drelectro/ns32k-timewarp/Memory.kicad_sch

## KiCad design Memory.kicad_sch (2025-10-30)

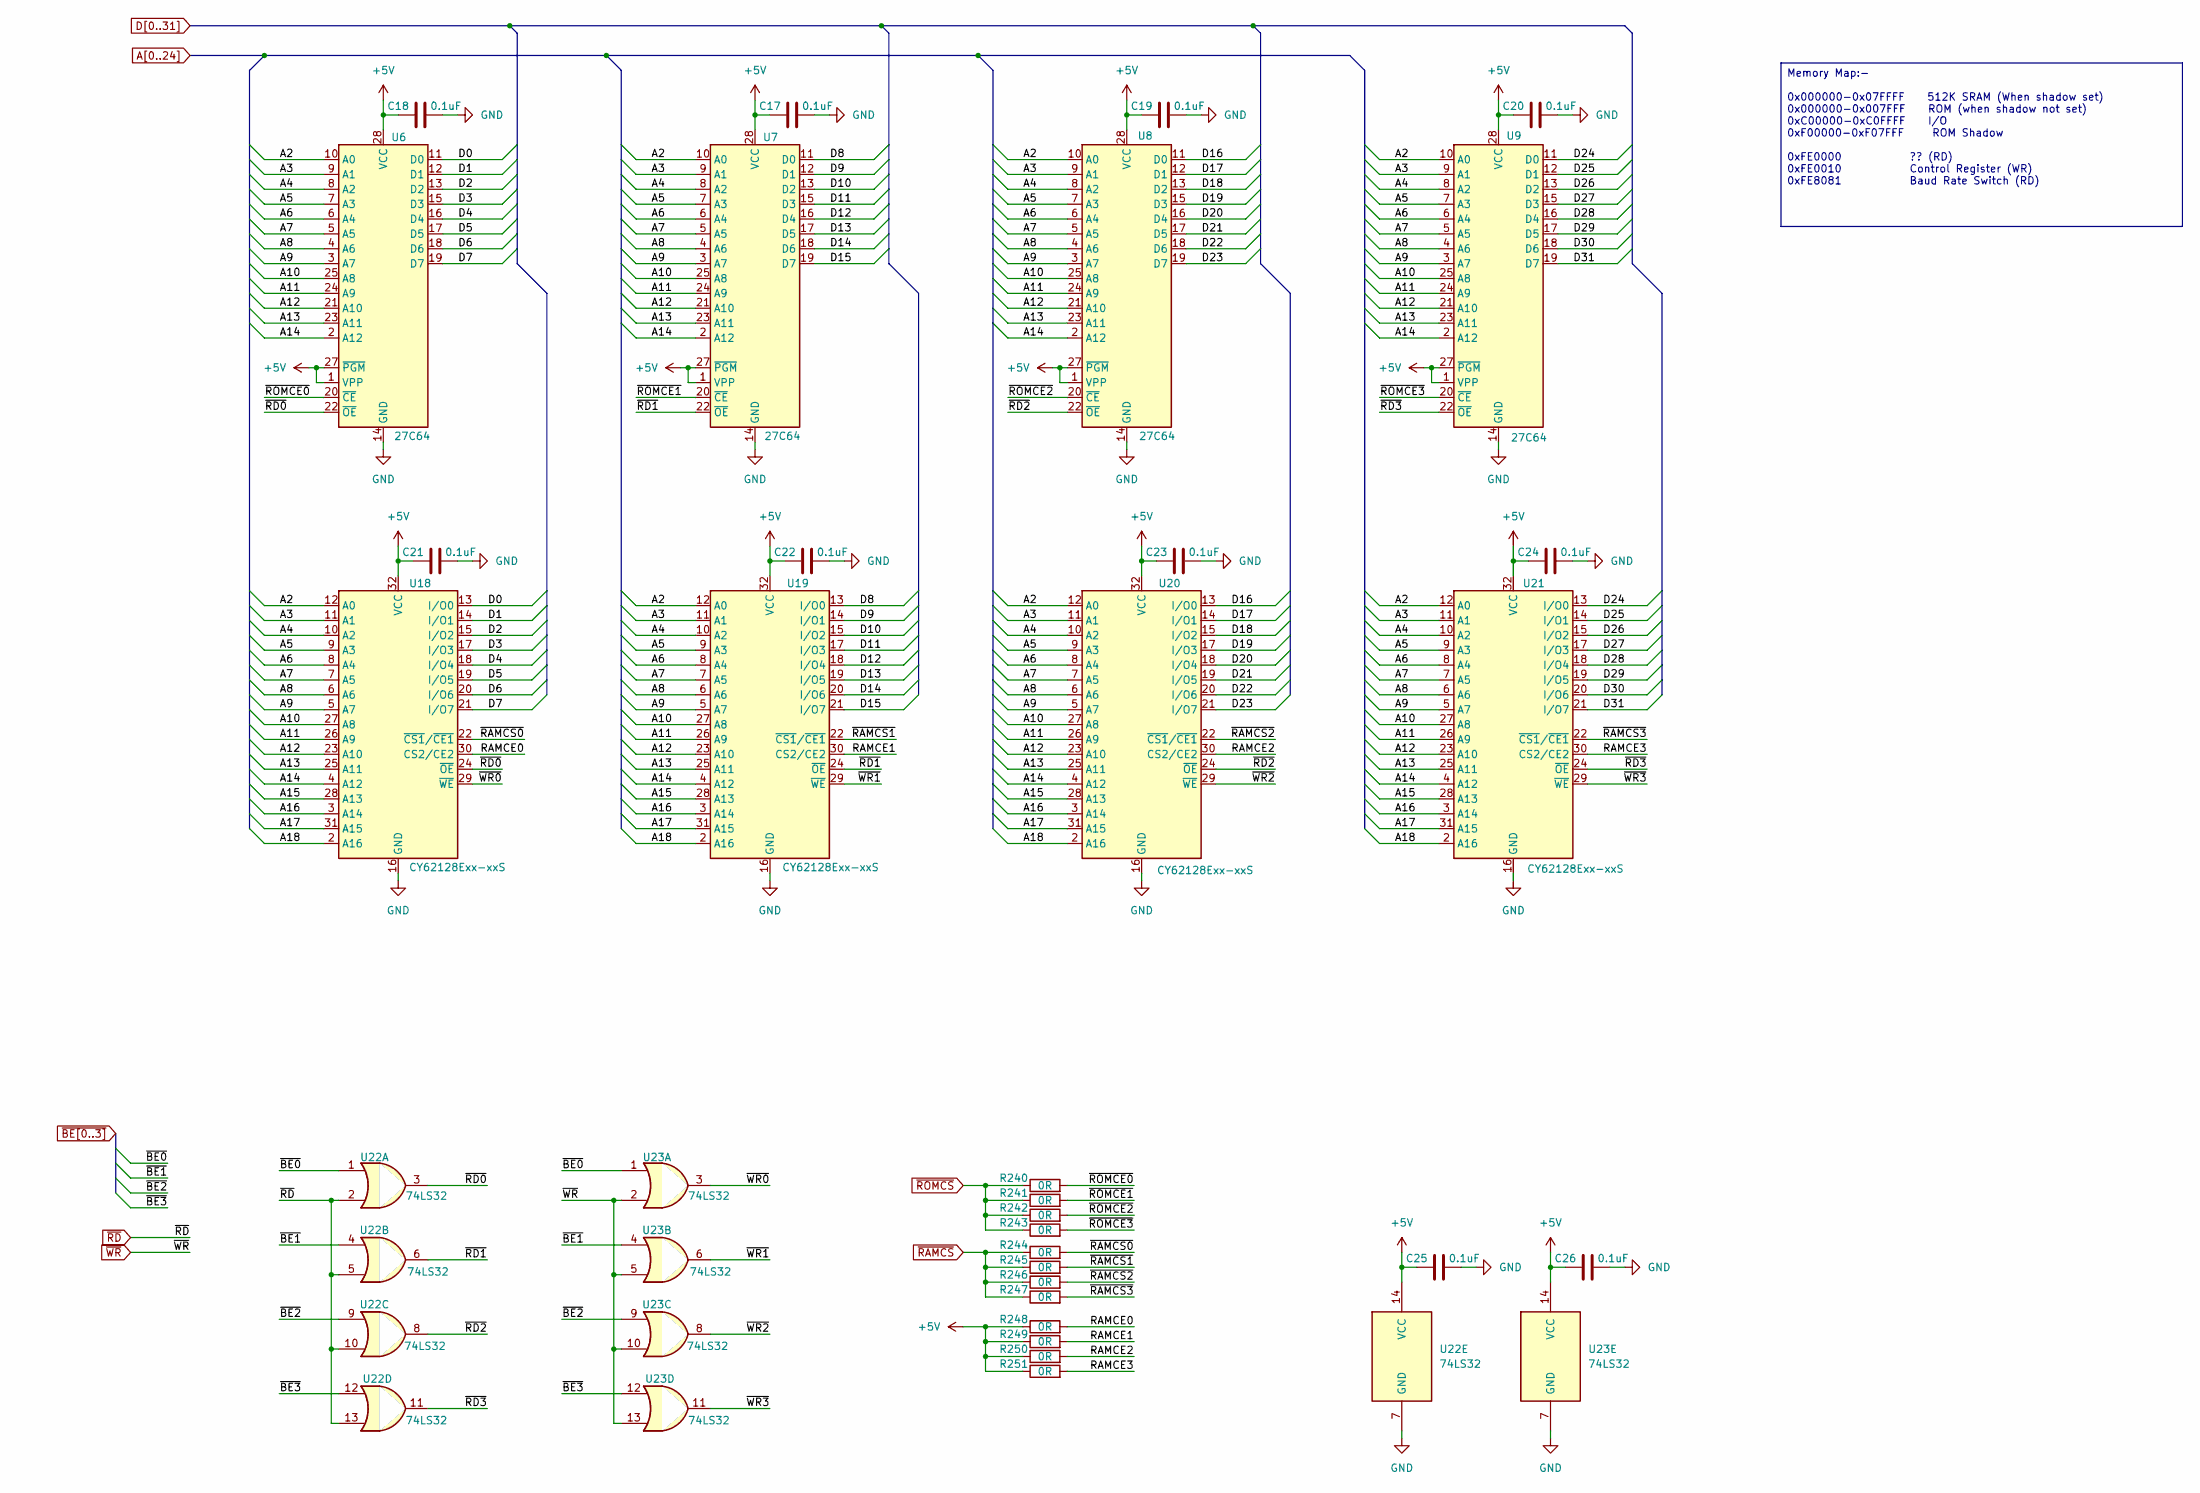
[picture p1: schematic Memory.kicad_sch]

Parts:
C17, C18, C19, C20, C21, C22, C23, C24, C25, C26: 0.1uF; C_0603_1608Metric_Pad1.08x0.95mm_HandSolder
R240, R241, R242, R243, R244, R245, R246, R247, R248, R249, R250, R251: 0R; R_0603_1608Metric_Pad0.98x0.95mm_HandSolder
U6, U7, U8, U9: 27C64; DIP-28_W15.24mm
U18, U19, U20, U21: CY62128Exx-xxS; SOP-32_11.305x20.495mm_P1.27mm
U22, U23: 74LS32; DIP-14_W7.62mm_Socket_LongPads

Connections:
+5V: C17.1, C18.1, C19.1, C20.1, C21.1, C22.1, C23.1, C24.1, C25.1, C26.1, R248.1, R249.1, R250.1, R251.1, U6.1 (VPP), U6.27 (~PGM), U6.28 (VCC), U7.1 (VPP), U7.27 (~PGM), U7.28 (VCC), U8.1 (VPP), U8.27 (~PGM), U8.28 (VCC), U9.1 (VPP), U9.27 (~PGM), U9.28 (VCC), U18.32 (VCC), U19.32 (VCC), U20.32 (VCC), U21.32 (VCC), U22.14 (VCC), U23.14 (VCC)
A2: U6.10 (A0), U7.10 (A0), U8.10 (A0), U9.10 (A0), U18.12 (A0), U19.12 (A0), U20.12 (A0), U21.12 (A0)
A3: U6.9 (A1), U7.9 (A1), U8.9 (A1), U9.9 (A1), U18.11 (A1), U19.11 (A1), U20.11 (A1), U21.11 (A1)
A4: U6.8 (A2), U7.8 (A2), U8.8 (A2), U9.8 (A2), U18.10 (A2), U19.10 (A2), U20.10 (A2), U21.10 (A2)
A5: U6.7 (A3), U7.7 (A3), U8.7 (A3), U9.7 (A3), U18.9 (A3), U19.9 (A3), U20.9 (A3), U21.9 (A3)
A6: U6.6 (A4), U7.6 (A4), U8.6 (A4), U9.6 (A4), U18.8 (A4), U19.8 (A4), U20.8 (A4), U21.8 (A4)
A7: U6.5 (A5), U7.5 (A5), U8.5 (A5), U9.5 (A5), U18.7 (A5), U19.7 (A5), U20.7 (A5), U21.7 (A5)
A8: U6.4 (A6), U7.4 (A6), U8.4 (A6), U9.4 (A6), U18.6 (A6), U19.6 (A6), U20.6 (A6), U21.6 (A6)
A9: U6.3 (A7), U7.3 (A7), U8.3 (A7), U9.3 (A7), U18.5 (A7), U19.5 (A7), U20.5 (A7), U21.5 (A7)
A10: U6.25 (A8), U7.25 (A8), U8.25 (A8), U9.25 (A8), U18.27 (A8), U19.27 (A8), U20.27 (A8), U21.27 (A8)
A11: U6.24 (A9), U7.24 (A9), U8.24 (A9), U9.24 (A9), U18.26 (A9), U19.26 (A9), U20.26 (A9), U21.26 (A9)
A12: U6.21 (A10), U7.21 (A10), U8.21 (A10), U9.21 (A10), U18.23 (A10), U19.23 (A10), U20.23 (A10), U21.23 (A10)
A13: U6.23 (A11), U7.23 (A11), U8.23 (A11), U9.23 (A11), U18.25 (A11), U19.25 (A11), U20.25 (A11), U21.25 (A11)
A14: U6.2 (A12), U7.2 (A12), U8.2 (A12), U9.2 (A12), U18.4 (A12), U19.4 (A12), U20.4 (A12), U21.4 (A12)
A15: U18.28 (A13), U19.28 (A13), U20.28 (A13), U21.28 (A13)
A16: U18.3 (A14), U19.3 (A14), U20.3 (A14), U21.3 (A14)
A17: U18.31 (A15), U19.31 (A15), U20.31 (A15), U21.31 (A15)
A18: U18.2 (A16), U19.2 (A16), U20.2 (A16), U21.2 (A16)
D0: U6.11 (D0), U18.13 (I/O0)
D1: U6.12 (D1), U18.14 (I/O1)
D2: U6.13 (D2), U18.15 (I/O2)
D3: U6.15 (D3), U18.17 (I/O3)
D4: U6.16 (D4), U18.18 (I/O4)
D5: U6.17 (D5), U18.19 (I/O5)
D6: U6.18 (D6), U18.20 (I/O6)
D7: U6.19 (D7), U18.21 (I/O7)
D8: U7.11 (D0), U19.13 (I/O0)
D9: U7.12 (D1), U19.14 (I/O1)
D10: U7.13 (D2), U19.15 (I/O2)
D11: U7.15 (D3), U19.17 (I/O3)
D12: U7.16 (D4), U19.18 (I/O4)
D13: U7.17 (D5), U19.19 (I/O5)
D14: U7.18 (D6), U19.20 (I/O6)
D15: U7.19 (D7), U19.21 (I/O7)
D16: U8.11 (D0), U20.13 (I/O0)
D17: U8.12 (D1), U20.14 (I/O1)
D18: U8.13 (D2), U20.15 (I/O2)
D19: U8.15 (D3), U20.17 (I/O3)
D20: U8.16 (D4), U20.18 (I/O4)
D21: U8.17 (D5), U20.19 (I/O5)
D22: U8.18 (D6), U20.20 (I/O6)
D23: U8.19 (D7), U20.21 (I/O7)
D24: U9.11 (D0), U21.13 (I/O0)
D25: U9.12 (D1), U21.14 (I/O1)
D26: U9.13 (D2), U21.15 (I/O2)
D27: U9.15 (D3), U21.17 (I/O3)
D28: U9.16 (D4), U21.18 (I/O4)
D29: U9.17 (D5), U21.19 (I/O5)
D30: U9.18 (D6), U21.20 (I/O6)
D31: U9.19 (D7), U21.21 (I/O7)
GND: C17.2, C18.2, C19.2, C20.2, C21.2, C22.2, C23.2, C24.2, C25.2, C26.2, U6.14 (GND), U7.14 (GND), U8.14 (GND), U9.14 (GND), U18.16 (GND), U19.16 (GND), U20.16 (GND), U21.16 (GND), U22.7 (GND), U23.7 (GND)
RAMCE0: R248.2, U18.30 (CS2/CE2)
RAMCE1: R249.2, U19.30 (CS2/CE2)
RAMCE2: R250.2, U20.30 (CS2/CE2)
RAMCE3: R251.2, U21.30 (CS2/CE2)
~BE0: U22.1, U23.1
~BE1: U22.4, U23.4
~BE2: U22.9, U23.9
~BE3: U22.12, U23.12
~RAMCS0: R244.2, U18.22 (~CS1/~CE1)
~RAMCS1: R245.2, U19.22 (~CS1/~CE1)
~RAMCS2: R246.2, U20.22 (~CS1/~CE1)
~RAMCS3: R247.2, U21.22 (~CS1/~CE1)
~RAMCS: R244.1, R245.1, R246.1, R247.1
~RD0: U6.22 (~OE), U18.24 (~OE), U22.3
~RD1: U7.22 (~OE), U19.24 (~OE), U22.6
~RD2: U8.22 (~OE), U20.24 (~OE), U22.8
~RD3: U9.22 (~OE), U21.24 (~OE), U22.11
~RD: U22.2, U22.5, U22.10, U22.13
~ROMCE0: R240.2, U6.20 (~CE)
~ROMCE1: R241.2, U7.20 (~CE)
~ROMCE2: R242.2, U8.20 (~CE)
~ROMCE3: R243.2, U9.20 (~CE)
~ROMCS: R240.1, R241.1, R242.1, R243.1
~WR0: U18.29 (~WE), U23.3
~WR1: U19.29 (~WE), U23.6
~WR2: U20.29 (~WE), U23.8
~WR3: U21.29 (~WE), U23.11
~WR: U23.2, U23.5, U23.10, U23.13

Notes on the sheet:
Memory Map:- 0x000000-0x07FFFF 512K SRAM (When shadow set) 0x000000-0x007FFF ROM (when shadow not set) 0xC00000-0xC0FFFF I/O 0xF00000-0xF07FFF ROM Shadow 0xFE0000 ?? (RD) 0xFE0010 Control Register (WR) 0xFE8081 Baud Rate Switch (RD)
