drelectro/ns32k-timewarp/Peripherals.kicad_sch

## KiCad design Peripherals.kicad_sch (2025-10-30)

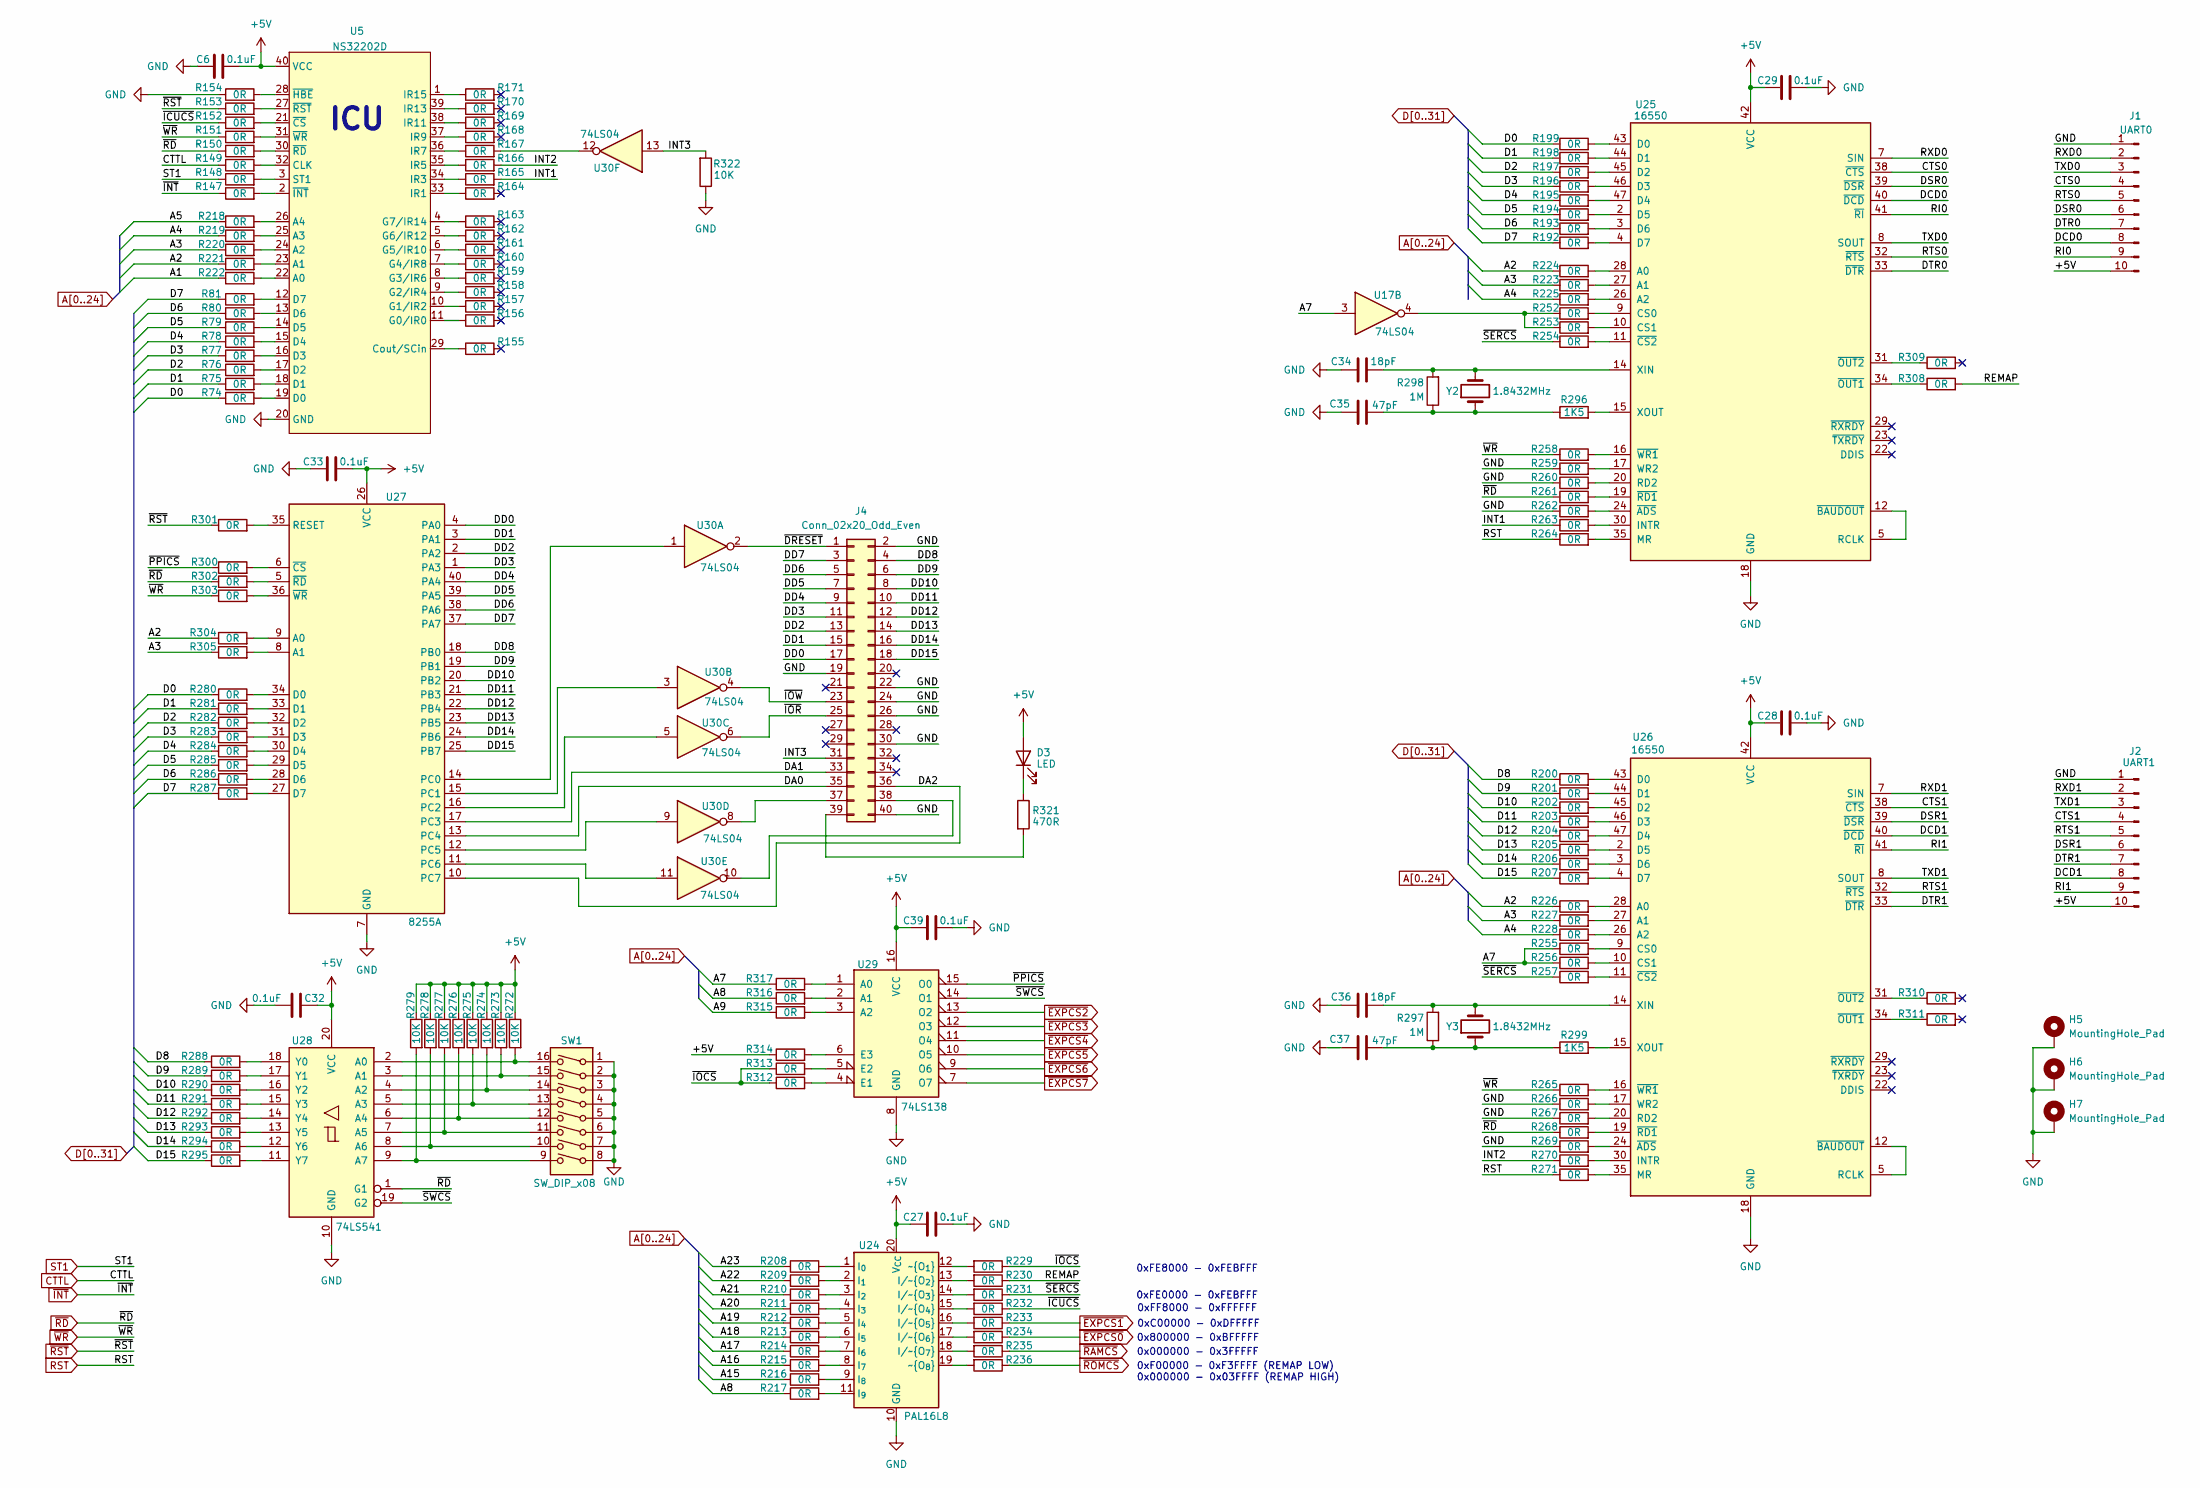
[picture p2: schematic Peripherals.kicad_sch]

Parts:
C6, C27, C28, C29, C32, C33, C39: 0.1uF; C_0603_1608Metric_Pad1.08x0.95mm_HandSolder
C34, C36: 18pF; C_0603_1608Metric_Pad1.08x0.95mm_HandSolder
C35, C37: 47pF; C_0603_1608Metric_Pad1.08x0.95mm_HandSolder
D3: LED; LED_0805_2012Metric_Pad1.15x1.40mm_HandSolder
H5, H6, H7: MountingHole_Pad; MountingHole_3mm_Pad
J1: UART0; PinHeader_1x10_P2.54mm_Vertical
J2: UART1; PinHeader_1x10_P2.54mm_Vertical
J4: Conn_02x20_Odd_Even; PinHeader_2x20_P2.54mm_Vertical
R74, R75, R76, R77, R78, R79, R80, R81, R147, R148, R149, R150, R151, R152, R153, R154, R155, R156, R157, R158, R159, R160, R161, R162, R163, R164, R165, R166, R167, R168, R169, R170, R171, R192, R193, R194, R195, R196, R197, R198, R199, R200, R201, R202, R203, R204, R205, R206, R207, R208, R209, R210, R211, R212, R213, R214, R215, R216, R217, R218, R219, R220, R221, R222, R223, R224, R225, R226, R227, R228, R229, R230, R231, R232, R233, R234, R235, R236, R252, R253, R254, R255, R256, R257, R258, R259, R260, R261, R262, R263, R264, R265, R266, R267, R268, R269, R270, R271, R280, R281, R282, R283, R284, R285, R286, R287, R288, R289, R290, R291, R292, R293, R294, R295, R300, R301, R302, R303, R304, R305, R308, R309, R310, R311, R312, R313, R314, R315, R316, R317: 0R; R_0603_1608Metric_Pad0.98x0.95mm_HandSolder
R272, R273, R274, R275, R276, R277, R278, R279, R322: 10K; R_0603_1608Metric_Pad0.98x0.95mm_HandSolder
R296, R299: 1K5; R_0603_1608Metric_Pad0.98x0.95mm_HandSolder
R297, R298: 1M; R_0603_1608Metric_Pad0.98x0.95mm_HandSolder
R321: 470R; R_0603_1608Metric_Pad0.98x0.95mm_HandSolder
SW1: SW_DIP_x08; DIP-16_W7.62mm_Socket_LongPads
U5: NS32202D; DIP-40_W15.24mm_Socket_LongPads
U17, U30: 74LS04; DIP-14_W7.62mm_Socket_LongPads
U24: PAL16L8; DIP-20_W7.62mm_Socket_LongPads
U25, U26: 16550; LQFP-48_7x7mm_P0.5mm
U27: 8255A; DIP-40_W15.24mm
U28: 74LS541; DIP-20_W7.62mm_Socket_LongPads
U29: 74LS138; DIP-16_W7.62mm_Socket_LongPads
Y2, Y3: 1.8432MHz; Crystal_HC49-U_Vertical

Connections:
+5V: C6.2, C27.1, C28.1, C29.1, C32.1, C33.2, C39.1, D3.2 (A), J1.10, J2.10, R272.1, R273.1, R274.1, R275.1, R276.1, R277.1, R278.1, R279.1, R314.1, U5.40 (VCC), U24.20 (V_{CC}), U25.42 (VCC), U26.42 (VCC), U27.26 (VCC), U28.20 (VCC), U29.16 (VCC)
A1: R222.1
A2: R221.1, R224.1, R226.1, R304.1
A3: R220.1, R223.1, R227.1, R305.1
A4: R219.1, R225.1, R228.1
A5: R218.1
A7: R255.1, R256.1, R317.1, U17.3
A8: R217.1, R316.1
A9: R315.1
A15: R216.1
A16: R215.1
A17: R214.1
A18: R213.1
A19: R212.1
A20: R211.1
A21: R210.1
A22: R209.1
A23: R208.1
CTS0: J1.4, U25.38 (~CTS)
CTS1: J2.4, U26.38 (~CTS)
CTTL: R149.1
D0: R74.1, R199.1, R280.1
D1: R75.1, R198.1, R281.1
D2: R76.1, R197.1, R282.1
D3: R77.1, R196.1, R283.1
D4: R78.1, R195.1, R284.1
D5: R79.1, R194.1, R285.1
D6: R80.1, R193.1, R286.1
D7: R81.1, R192.1, R287.1
D8: R200.1, R288.1
D9: R201.1, R289.1
D10: R202.1, R290.1
D11: R203.1, R291.1
D12: R204.1, R292.1
D13: R205.1, R293.1
D14: R206.1, R294.1
D15: R207.1, R295.1
DA0: J4.35, U27.13 (PC4)
DA1: J4.33, U27.17 (PC3)
DA2: J4.36, U27.10 (PC7)
DCD0: J1.8, U25.40 (~DCD)
DCD1: J2.8, U26.40 (~DCD)
DD0: J4.17, U27.4 (PA0)
DD1: J4.15, U27.3 (PA1)
DD2: J4.13, U27.2 (PA2)
DD3: J4.11, U27.1 (PA3)
DD4: J4.9, U27.40 (PA4)
DD5: J4.7, U27.39 (PA5)
DD6: J4.5, U27.38 (PA6)
DD7: J4.3, U27.37 (PA7)
DD8: J4.4, U27.18 (PB0)
DD9: J4.6, U27.19 (PB1)
DD10: J4.8, U27.20 (PB2)
DD11: J4.10, U27.21 (PB3)
DD12: J4.12, U27.22 (PB4)
DD13: J4.14, U27.23 (PB5)
DD14: J4.16, U27.24 (PB6)
DD15: J4.18, U27.25 (PB7)
DSR0: J1.6, U25.39 (~DSR)
DSR1: J2.6, U26.39 (~DSR)
DTR0: J1.7, U25.33 (~DTR)
DTR1: J2.7, U26.33 (~DTR)
GND: C6.1, C27.2, C28.2, C29.2, C32.2, C33.1, C34.1, C35.1, C36.1, C37.1, C39.2, H5.1, H6.1, H7.1, J1.1, J2.1, J4.2, J4.19, J4.22, J4.24, J4.26, J4.30, J4.40, R154.1, R259.1, R260.1, R262.1, R266.1, R267.1, R269.1, R322.1, SW1.1, SW1.2, SW1.3, SW1.4, SW1.5, SW1.6, SW1.7, SW1.8, U5.20 (GND), U24.10 (GND), U25.18 (GND), U26.18 (GND), U27.7 (GND), U28.10 (GND), U29.8 (GND)
INT1: R165.2, R263.1
INT2: R166.2, R270.1
INT3: J4.31, R322.2, U30.13
unnamed: C34.2, R298.2, U25.14 (XIN), Y2.2
unnamed: C35.2, R296.1, R298.1, Y2.1
unnamed: C36.2, R297.2, U26.14 (XIN), Y3.2
unnamed: C37.2, R297.1, R299.1, Y3.1
unnamed: D3.1 (K), R321.1
unnamed: J4.37, U30.8
unnamed: J4.38, U30.10
unnamed: J4.39, R321.2
unnamed: R74.2, U5.19 (D0)
unnamed: R75.2, U5.18 (D1)
unnamed: R76.2, U5.17 (D2)
unnamed: R77.2, U5.16 (D3)
unnamed: R78.2, U5.15 (D4)
unnamed: R79.2, U5.14 (D5)
unnamed: R80.2, U5.13 (D6)
unnamed: R81.2, U5.12 (D7)
unnamed: R147.2, U5.2 (~INT)
unnamed: R148.2, U5.3 (ST1)
unnamed: R149.2, U5.32 (CLK)
unnamed: R150.2, U5.30 (~RD)
unnamed: R151.2, U5.31 (~WR)
unnamed: R152.2, U5.21 (~CS)
unnamed: R153.2, U5.27 (~RST)
unnamed: R154.2, U5.28 (~HBE)
unnamed: R155.1, U5.29 (Cout/SCin)
unnamed: R156.1, U5.11 (G0/IR0)
unnamed: R157.1, U5.10 (G1/IR2)
unnamed: R158.1, U5.9 (G2/IR4)
unnamed: R159.1, U5.8 (G3/IR6)
unnamed: R160.1, U5.7 (G4/IR8)
unnamed: R161.1, U5.6 (G5/IR10)
unnamed: R162.1, U5.5 (G6/IR12)
unnamed: R163.1, U5.4 (G7/IR14)
unnamed: R164.1, U5.33 (IR1)
unnamed: R165.1, U5.34 (IR3)
unnamed: R166.1, U5.35 (IR5)
unnamed: R167.1, U5.36 (IR7)
unnamed: R167.2, U30.12
unnamed: R168.1, U5.37 (IR9)
unnamed: R169.1, U5.38 (IR11)
unnamed: R170.1, U5.39 (IR13)
unnamed: R171.1, U5.1 (IR15)
unnamed: R192.2, U25.4 (D7)
unnamed: R193.2, U25.3 (D6)
unnamed: R194.2, U25.2 (D5)
unnamed: R195.2, U25.47 (D4)
unnamed: R196.2, U25.46 (D3)
unnamed: R197.2, U25.45 (D2)
unnamed: R198.2, U25.44 (D1)
unnamed: R199.2, U25.43 (D0)
unnamed: R200.2, U26.43 (D0)
unnamed: R201.2, U26.44 (D1)
unnamed: R202.2, U26.45 (D2)
unnamed: R203.2, U26.46 (D3)
unnamed: R204.2, U26.47 (D4)
unnamed: R205.2, U26.2 (D5)
unnamed: R206.2, U26.3 (D6)
unnamed: R207.2, U26.4 (D7)
unnamed: R208.2, U24.1 (I_{0})
unnamed: R209.2, U24.2 (I_{1})
unnamed: R210.2, U24.3 (I_{2})
unnamed: R211.2, U24.4 (I_{3})
unnamed: R212.2, U24.5 (I_{4})
unnamed: R213.2, U24.6 (I_{5})
unnamed: R214.2, U24.7 (I_{6})
unnamed: R215.2, U24.8 (I_{7})
unnamed: R216.2, U24.9 (I_{8})
unnamed: R217.2, U24.11 (I_{9})
unnamed: R218.2, U5.26 (A4)
unnamed: R219.2, U5.25 (A3)
unnamed: R220.2, U5.24 (A2)
unnamed: R221.2, U5.23 (A1)
unnamed: R222.2, U5.22 (A0)
unnamed: R223.2, U25.27 (A1)
unnamed: R224.2, U25.28 (A0)
unnamed: R225.2, U25.26 (A2)
unnamed: R226.2, U26.28 (A0)
unnamed: R227.2, U26.27 (A1)
unnamed: R228.2, U26.26 (A2)
unnamed: R229.2, U24.12 (~O_{1})
unnamed: R230.2, U24.13 (I/~O_{2})
unnamed: R231.2, U24.14 (I/~O_{3})
unnamed: R232.2, U24.15 (I/~O_{4})
unnamed: R233.2, U24.16 (I/~O_{5})
unnamed: R234.2, U24.17 (I/~O_{6})
unnamed: R235.2, U24.18 (I/~O_{7})
unnamed: R236.2, U24.19 (~O_{8})
unnamed: R252.1, R253.1, U17.4
unnamed: R252.2, U25.9 (CS0)
unnamed: R253.2, U25.10 (CS1)
unnamed: R254.2, U25.11 (~CS2)
unnamed: R255.2, U26.9 (CS0)
unnamed: R256.2, U26.10 (CS1)
unnamed: R257.2, U26.11 (~CS2)
unnamed: R258.2, U25.16 (~WR1)
unnamed: R259.2, U25.17 (WR2)
unnamed: R260.2, U25.20 (RD2)
unnamed: R261.2, U25.19 (~RD1)
unnamed: R262.2, U25.24 (~ADS)
unnamed: R263.2, U25.30 (INTR)
unnamed: R264.2, U25.35 (MR)
unnamed: R265.2, U26.16 (~WR1)
unnamed: R266.2, U26.17 (WR2)
unnamed: R267.2, U26.20 (RD2)
unnamed: R268.2, U26.19 (~RD1)
unnamed: R269.2, U26.24 (~ADS)
unnamed: R270.2, U26.30 (INTR)
unnamed: R271.2, U26.35 (MR)
unnamed: R272.2, SW1.16, U28.2 (A0)
unnamed: R273.2, SW1.15, U28.3 (A1)
unnamed: R274.2, SW1.14, U28.4 (A2)
unnamed: R275.2, SW1.13, U28.5 (A3)
unnamed: R276.2, SW1.12, U28.6 (A4)
unnamed: R277.2, SW1.11, U28.7 (A5)
unnamed: R278.2, SW1.10, U28.8 (A6)
unnamed: R279.2, SW1.9, U28.9 (A7)
unnamed: R280.2, U27.34 (D0)
unnamed: R281.2, U27.33 (D1)
unnamed: R282.2, U27.32 (D2)
unnamed: R283.2, U27.31 (D3)
unnamed: R284.2, U27.30 (D4)
unnamed: R285.2, U27.29 (D5)
unnamed: R286.2, U27.28 (D6)
unnamed: R287.2, U27.27 (D7)
unnamed: R288.2, U28.18 (Y0)
unnamed: R289.2, U28.17 (Y1)
unnamed: R290.2, U28.16 (Y2)
unnamed: R291.2, U28.15 (Y3)
unnamed: R292.2, U28.14 (Y4)
unnamed: R293.2, U28.13 (Y5)
unnamed: R294.2, U28.12 (Y6)
unnamed: R295.2, U28.11 (Y7)
unnamed: R296.2, U25.15 (XOUT)
unnamed: R299.2, U26.15 (XOUT)
unnamed: R300.2, U27.6 (~CS)
unnamed: R301.2, U27.35 (RESET)
unnamed: R302.2, U27.5 (~RD)
unnamed: R303.2, U27.36 (~WR)
unnamed: R304.2, U27.9 (A0)
unnamed: R305.2, U27.8 (A1)
unnamed: R308.1, U25.34 (~OUT1)
unnamed: R309.1, U25.31 (~OUT2)
unnamed: R310.1, U26.31 (~OUT2)
unnamed: R311.1, U26.34 (~OUT1)
unnamed: R312.2, U29.4 (E1)
unnamed: R313.2, U29.5 (E2)
unnamed: R314.2, U29.6 (E3)
unnamed: R315.2, U29.3 (A2)
unnamed: R316.2, U29.2 (A1)
unnamed: R317.2, U29.1 (A0)
unnamed: U25.5 (RCLK), U25.12 (~BAUDOUT)
unnamed: U26.5 (RCLK), U26.12 (~BAUDOUT)
unnamed: U27.11 (PC6), U30.11
unnamed: U27.12 (PC5), U30.9
unnamed: U27.14 (PC0), U30.1
unnamed: U27.15 (PC1), U30.3
unnamed: U27.16 (PC2), U30.5
REMAP: R230.1, R308.2
RI0: J1.9, U25.41 (~RI)
RI1: J2.9, U26.41 (~RI)
RST: R264.1, R271.1
RTS0: J1.5, U25.32 (~RTS)
RTS1: J2.5, U26.32 (~RTS)
RXD0: J1.2, U25.7 (SIN)
RXD1: J2.2, U26.7 (SIN)
ST1: R148.1
TXD0: J1.3, U25.8 (SOUT)
TXD1: J2.3, U26.8 (SOUT)
~DRESET: J4.1, U30.2
~EXPCS0: R234.1
~EXPCS1: R233.1
~EXPCS2: U29.13 (O2)
~EXPCS3: U29.12 (O3)
~EXPCS4: U29.11 (O4)
~EXPCS5: U29.10 (O5)
~EXPCS6: U29.9 (O6)
~EXPCS7: U29.7 (O7)
~ICUCS: R152.1, R232.1
~INT: R147.1
~IOCS: R229.1, R312.1, R313.1
~IOR: J4.25, U30.6
~IOW: J4.23, U30.4
~PPICS: R300.1, U29.15 (O0)
~RAMCS: R235.1
~RD: R150.1, R261.1, R268.1, R302.1, U28.1 (G1)
~ROMCS: R236.1
~RST: R153.1, R301.1
~SERCS: R231.1, R254.1, R257.1
~SWCS: U28.19 (G2), U29.14 (O1)
~WR: R151.1, R258.1, R265.1, R303.1

Notes on the sheet:
0xFF8000 - 0xFFFFFF
0x000000 - 0x3FFFFF
0x800000 - 0xBFFFFF
ICU
0xFE0000 - 0xFEBFFF
0xF00000 - 0xF3FFFF (REMAP LOW) 0x000000 - 0x03FFFF (REMAP HIGH)
0xFE8000 - 0xFEBFFF
0xC00000 - 0xDFFFFF
