drelectro/ns32k-timewarp/Power_Misc.kicad_sch

## KiCad design Power_Misc.kicad_sch (2025-10-30)

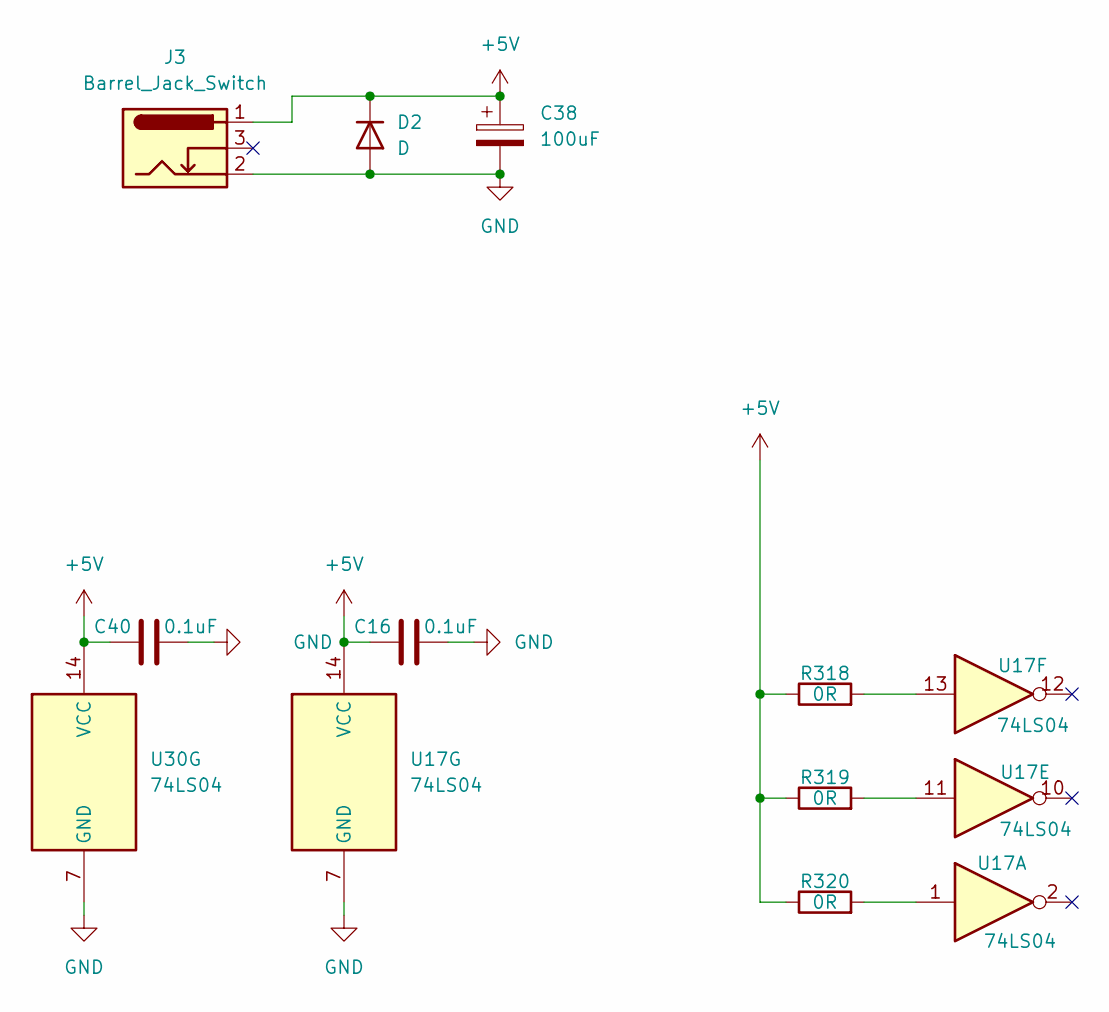
[picture p3: schematic Power_Misc.kicad_sch]

Parts:
C16, C40: 0.1uF; C_0603_1608Metric_Pad1.08x0.95mm_HandSolder
C38: 100uF; CP_Radial_D10.0mm_P5.00mm
D2: D; D_SMA_Handsoldering
J3: Barrel_Jack_Switch; BarrelJack_CUI_PJ-102AH_Horizontal
R318, R319, R320: 0R; R_0603_1608Metric_Pad0.98x0.95mm_HandSolder
U17, U30: 74LS04; DIP-14_W7.62mm_Socket_LongPads

Connections:
+5V: C16.1, C38.1, C40.1, D2.1 (K), J3.1, R318.1, R319.1, R320.1, U17.14 (VCC), U30.14 (VCC)
GND: C16.2, C38.2, C40.2, D2.2 (A), J3.2, U17.7 (GND), U30.7 (GND)
unnamed: R318.2, U17.13
unnamed: R319.2, U17.11
unnamed: R320.2, U17.1
