drelectro/ns32k-timewarp/ns32k-timewarp.kicad_sch

## KiCad design ns32k-timewarp.kicad_sch (2025-10-30)

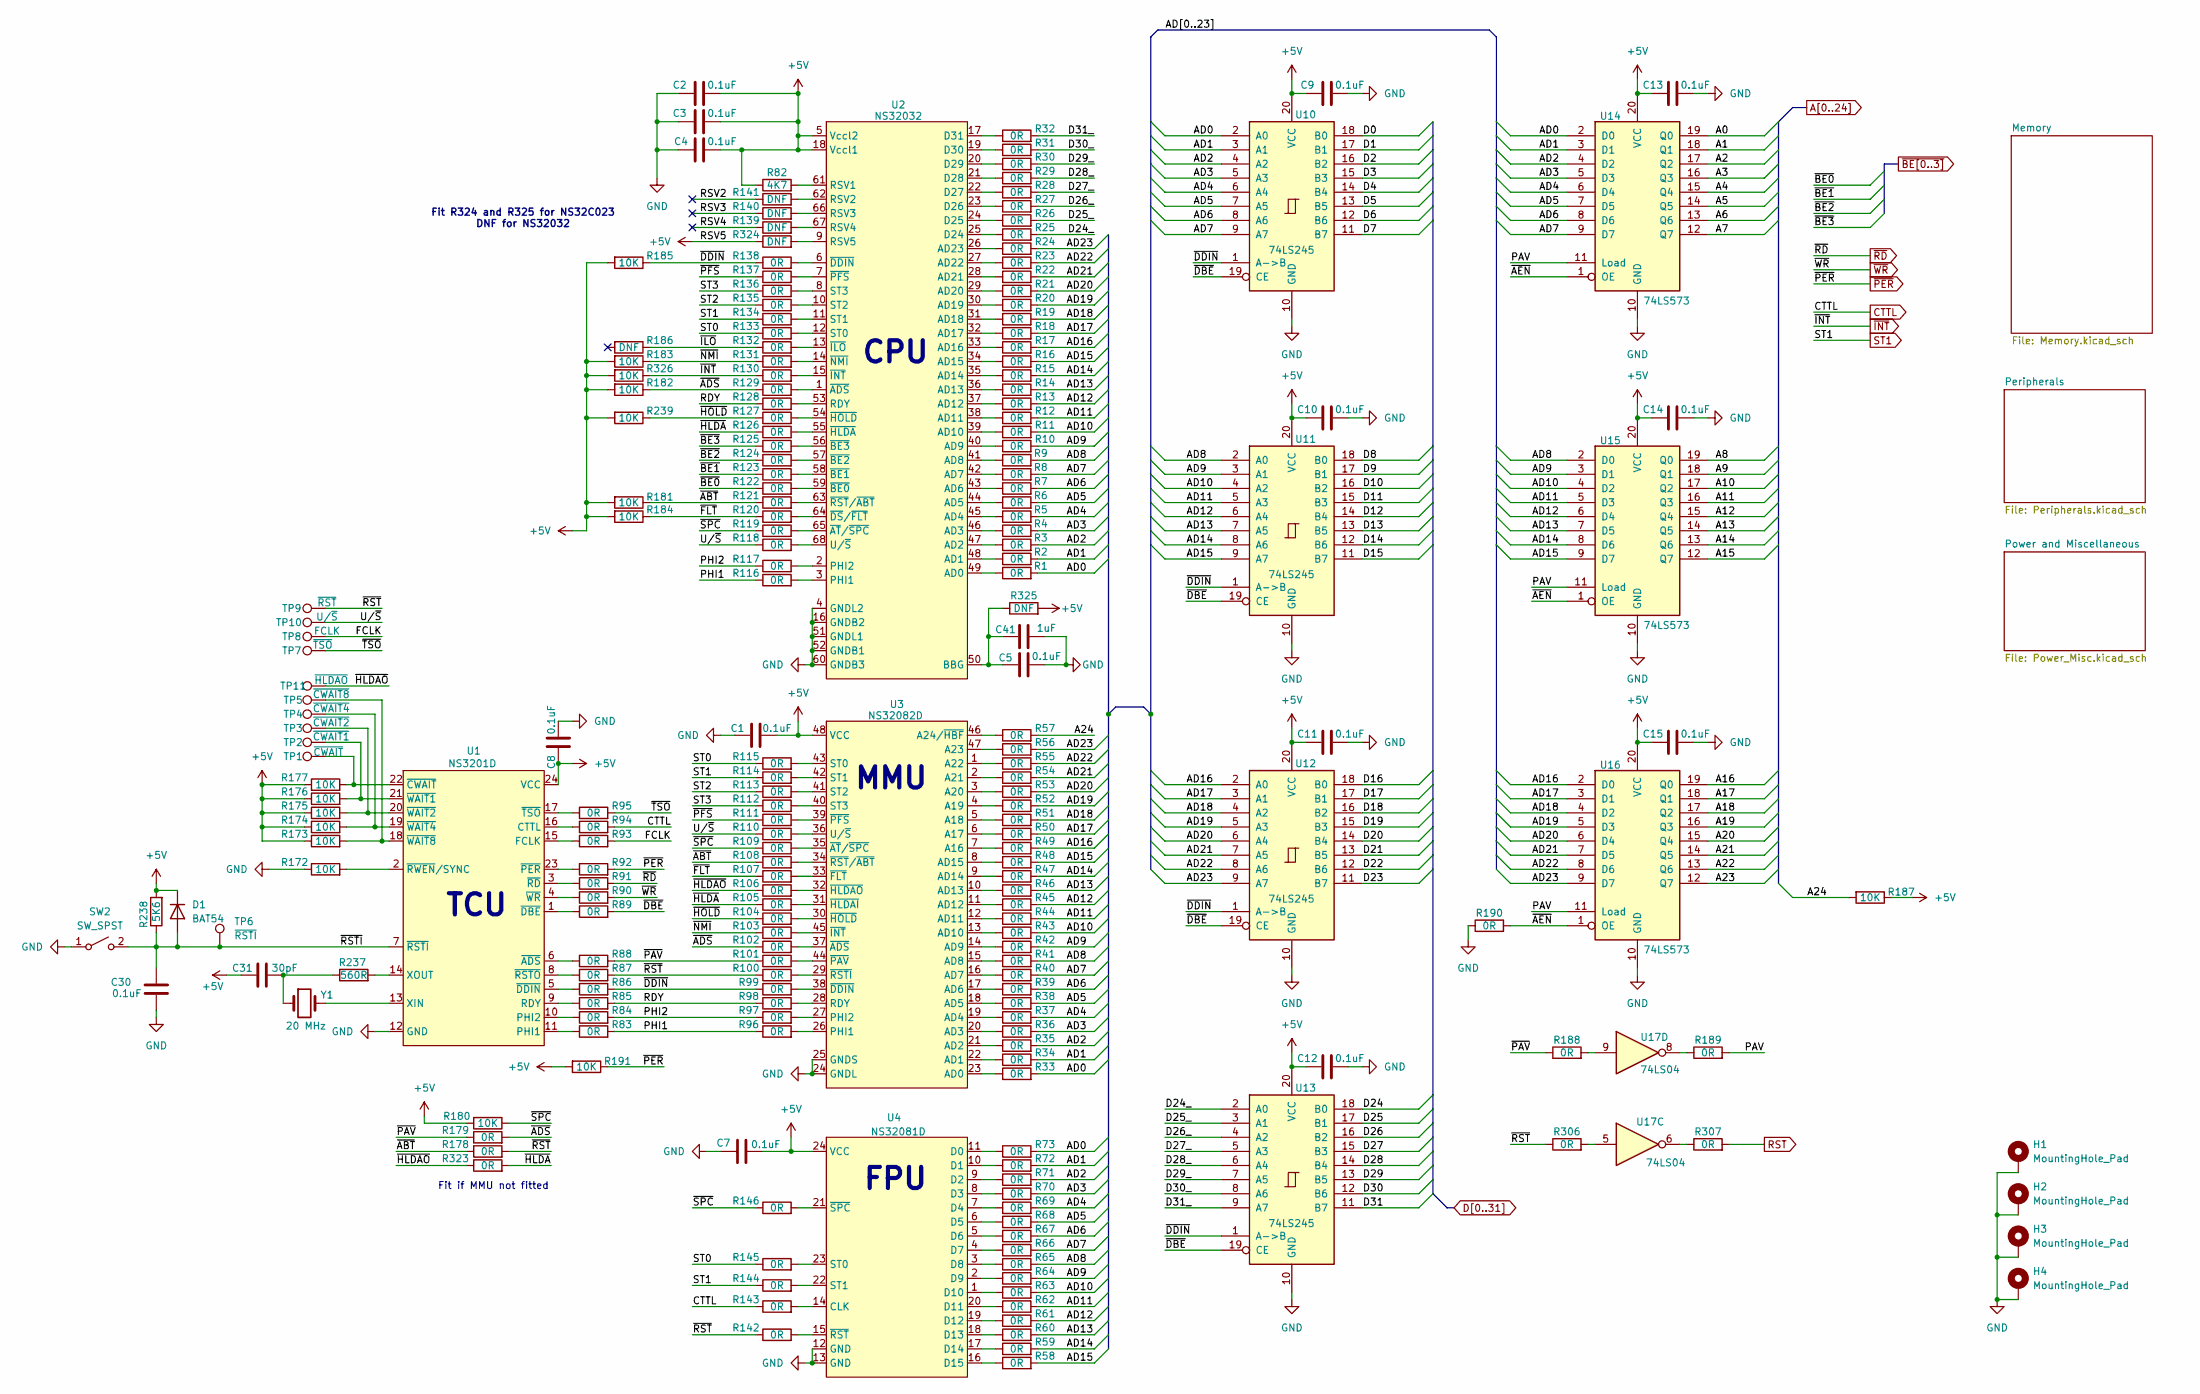
[picture p4: schematic ns32k-timewarp.kicad_sch]

Parts:
C1, C2, C3, C4, C5, C7, C8, C9, C10, C11, C12, C13, C14, C15, C30: 0.1uF; C_0603_1608Metric_Pad1.08x0.95mm_HandSolder
C31: 30pF; C_0603_1608Metric_Pad1.08x0.95mm_HandSolder
C41: 1uF; C_0603_1608Metric_Pad1.08x0.95mm_HandSolder
D1: BAT54; SOT-23-3
H1, H2, H3, H4: MountingHole_Pad; MountingHole_3mm_Pad
R1, R2, R3, R4, R5, R6, R7, R8, R9, R10, R11, R12, R13, R14, R15, R16, R17, R18, R19, R20, R21, R22, R23, R24, R25, R26, R27, R28, R29, R30, R31, R32, R33, R34, R35, R36, R37, R38, R39, R40, R41, R42, R43, R44, R45, R46, R47, R48, R49, R50, R51, R52, R53, R54, R55, R56, R57, R58, R59, R60, R61, R62, R63, R64, R65, R66, R67, R68, R69, R70, R71, R72, R73, R83, R84, R85, R86, R87, R88, R89, R90, R91, R92, R93, R94, R95, R96, R97, R98, R99, R100, R101, R102, R103, R104, R105, R106, R107, R108, R109, R110, R111, R112, R113, R114, R115, R116, R117, R118, R119, R120, R121, R122, R123, R124, R125, R126, R127, R128, R129, R130, R131, R132, R133, R134, R135, R136, R137, R138, R142, R143, R144, R145, R146, R178, R179, R188, R189, R190, R306, R307, R323: 0R; R_0603_1608Metric_Pad0.98x0.95mm_HandSolder
R82: 4K7; R_0603_1608Metric_Pad0.98x0.95mm_HandSolder
R139, R140, R141, R186, R324, R325: DNF; R_0603_1608Metric_Pad0.98x0.95mm_HandSolder
R172, R173, R174, R175, R176, R177, R180, R181, R182, R183, R184, R185, R187, R191, R239, R326: 10K; R_0603_1608Metric_Pad0.98x0.95mm_HandSolder
R237: 560R; R_0603_1608Metric_Pad0.98x0.95mm_HandSolder
R238: 5K6; R_0603_1608Metric_Pad0.98x0.95mm_HandSolder
SW2: SW_SPST; SW_TH_Tactile_Omron_B3F-1110
TP1: ~{CWAIT}; TestPoint_Pad_1.5x1.5mm
TP2: ~{CWAIT1}; TestPoint_Pad_1.5x1.5mm
TP3: ~{CWAIT2}; TestPoint_Pad_1.5x1.5mm
TP4: ~{CWAIT4}; TestPoint_Pad_1.5x1.5mm
TP5: ~{CWAIT8}; TestPoint_Pad_1.5x1.5mm
TP6: ~{RSTI}; TestPoint_Pad_1.5x1.5mm
TP7: ~{TSO}; TestPoint_Pad_1.5x1.5mm
TP8: FCLK; TestPoint_Pad_1.5x1.5mm
TP9: ~{RST}; TestPoint_Pad_1.5x1.5mm
TP10: U/~{S}; TestPoint_Pad_1.5x1.5mm
TP11: ~{HLDAO}; TestPoint_Pad_1.5x1.5mm
U1: NS3201D; DIP-24_18.0mmx34.29mm_W15.24mm_Socket_LongPads
U2: NS32032; PLCC-68_THT-Socket
U3: NS32082D; DIP-48_W15.24mm_Socket_LongPads
U4: NS32081D; DIP-24_18.0mmx34.29mm_W15.24mm_Socket_LongPads
U10, U11, U12, U13: 74LS245; DIP-20_W7.62mm_Socket_LongPads
U14, U15, U16: 74LS573; DIP-20_W7.62mm_Socket_LongPads
U17: 74LS04; DIP-14_W7.62mm_Socket_LongPads
Y1: 20 MHz; Crystal_HC49-U_Vertical

Connections:
+5V: C1.2, C2.2, C3.2, C4.2, C7.2, C8.1, C9.1, C10.1, C11.1, C12.1, C13.1, C14.1, C15.1, C31.1, D1.3 (K), R82.1, R173.1, R174.1, R175.1, R176.1, R177.1, R180.2, R181.2, R182.2, R183.2, R184.2, R185.2, R187.1, R191.2, R238.2, R239.2, R324.1, R325.2, R326.2, U1.24 (VCC), U2.5 (Vccl2), U2.18 (Vccl1), U3.48 (VCC), U4.24 (VCC), U10.20 (VCC), U11.20 (VCC), U12.20 (VCC), U13.20 (VCC), U14.20 (VCC), U15.20 (VCC), U16.20 (VCC)
A0: U14.19 (Q0)
A1: U14.18 (Q1)
A2: U14.17 (Q2)
A3: U14.16 (Q3)
A4: U14.15 (Q4)
A5: U14.14 (Q5)
A6: U14.13 (Q6)
A7: U14.12 (Q7)
A8: U15.19 (Q0)
A9: U15.18 (Q1)
A10: U15.17 (Q2)
A11: U15.16 (Q3)
A12: U15.15 (Q4)
A13: U15.14 (Q5)
A14: U15.13 (Q6)
A15: U15.12 (Q7)
A16: U16.19 (Q0)
A17: U16.18 (Q1)
A18: U16.17 (Q2)
A19: U16.16 (Q3)
A20: U16.15 (Q4)
A21: U16.14 (Q5)
A22: U16.13 (Q6)
A23: U16.12 (Q7)
A24: R57.2, R187.2
AD0: R1.2, R33.2, R73.2, U10.2 (A0), U14.2 (D0)
AD1: R2.2, R34.2, R72.2, U10.3 (A1), U14.3 (D1)
AD2: R3.2, R35.2, R71.2, U10.4 (A2), U14.4 (D2)
AD3: R4.2, R36.2, R70.2, U10.5 (A3), U14.5 (D3)
AD4: R5.2, R37.2, R69.2, U10.6 (A4), U14.6 (D4)
AD5: R6.2, R38.2, R68.2, U10.7 (A5), U14.7 (D5)
AD6: R7.2, R39.2, R67.2, U10.8 (A6), U14.8 (D6)
AD7: R8.2, R40.2, R66.2, U10.9 (A7), U14.9 (D7)
AD8: R9.2, R41.2, R65.2, U11.2 (A0), U15.2 (D0)
AD9: R10.2, R42.2, R64.2, U11.3 (A1), U15.3 (D1)
AD10: R11.2, R43.2, R63.2, U11.4 (A2), U15.4 (D2)
AD11: R12.2, R44.2, R62.2, U11.5 (A3), U15.5 (D3)
AD12: R13.2, R45.2, R61.2, U11.6 (A4), U15.6 (D4)
AD13: R14.2, R46.2, R60.2, U11.7 (A5), U15.7 (D5)
AD14: R15.2, R47.2, R59.2, U11.8 (A6), U15.8 (D6)
AD15: R16.2, R48.2, R58.2, U11.9 (A7), U15.9 (D7)
AD16: R17.2, R49.2, U12.2 (A0), U16.2 (D0)
AD17: R18.2, R50.2, U12.3 (A1), U16.3 (D1)
AD18: R19.2, R51.2, U12.4 (A2), U16.4 (D2)
AD19: R20.2, R52.2, U12.5 (A3), U16.5 (D3)
AD20: R21.2, R53.2, U12.6 (A4), U16.6 (D4)
AD21: R22.2, R54.2, U12.7 (A5), U16.7 (D5)
AD22: R23.2, R55.2, U12.8 (A6), U16.8 (D6)
AD23: R24.2, R56.2, U12.9 (A7), U16.9 (D7)
CTTL: R94.2, R143.1
D0: U10.18 (B0)
D1: U10.17 (B1)
D2: U10.16 (B2)
D3: U10.15 (B3)
D4: U10.14 (B4)
D5: U10.13 (B5)
D6: U10.12 (B6)
D7: U10.11 (B7)
D8: U11.18 (B0)
D9: U11.17 (B1)
D10: U11.16 (B2)
D11: U11.15 (B3)
D12: U11.14 (B4)
D13: U11.13 (B5)
D14: U11.12 (B6)
D15: U11.11 (B7)
D16: U12.18 (B0)
D17: U12.17 (B1)
D18: U12.16 (B2)
D19: U12.15 (B3)
D20: U12.14 (B4)
D21: U12.13 (B5)
D22: U12.12 (B6)
D23: U12.11 (B7)
D24: U13.18 (B0)
D24_: R25.2, U13.2 (A0)
D25: U13.17 (B1)
D25_: R26.2, U13.3 (A1)
D26: U13.16 (B2)
D26_: R27.2, U13.4 (A2)
D27: U13.15 (B3)
D27_: R28.2, U13.5 (A3)
D28: U13.14 (B4)
D28_: R29.2, U13.6 (A4)
D29: U13.13 (B5)
D29_: R30.2, U13.7 (A5)
D30: U13.12 (B6)
D30_: R31.2, U13.8 (A6)
D31: U13.11 (B7)
D31_: R32.2, U13.9 (A7)
FCLK: R93.2, TP8.1
GND: C1.1, C2.1, C3.1, C4.1, C5.2, C7.1, C8.2, C9.2, C10.2, C11.2, C12.2, C13.2, C14.2, C15.2, C30.1, C41.2, H1.1, H2.1, H3.1, H4.1, R172.1, R190.1, SW2.1 (A), U1.12 (GND), U2.4 (GNDL2), U2.16 (GNDB2), U2.51 (GNDL1), U2.52 (GNDB1), U2.60 (GNDB3), U3.24 (GNDL), U3.25 (GNDS), U4.12 (GND), U4.13 (GND), U10.10 (GND), U11.10 (GND), U12.10 (GND), U13.10 (GND), U14.10 (GND), U15.10 (GND), U16.10 (GND)
unnamed: C31.2, R237.1, Y1.1
unnamed: C5.1, C41.1, R325.1, U2.50 (BBG)
unnamed: R1.1, U2.49 (AD0)
unnamed: R2.1, U2.48 (AD1)
unnamed: R3.1, U2.47 (AD2)
unnamed: R4.1, U2.46 (AD3)
unnamed: R5.1, U2.45 (AD4)
unnamed: R6.1, U2.44 (AD5)
unnamed: R7.1, U2.43 (AD6)
unnamed: R8.1, U2.42 (AD7)
unnamed: R9.1, U2.41 (AD8)
unnamed: R10.1, U2.40 (AD9)
unnamed: R11.1, U2.39 (AD10)
unnamed: R12.1, U2.38 (AD11)
unnamed: R13.1, U2.37 (AD12)
unnamed: R14.1, U2.36 (AD13)
unnamed: R15.1, U2.35 (AD14)
unnamed: R16.1, U2.34 (AD15)
unnamed: R17.1, U2.33 (AD16)
unnamed: R18.1, U2.32 (AD17)
unnamed: R19.1, U2.31 (AD18)
unnamed: R20.1, U2.30 (AD19)
unnamed: R21.1, U2.29 (AD20)
unnamed: R22.1, U2.28 (AD21)
unnamed: R23.1, U2.27 (AD22)
unnamed: R24.1, U2.26 (AD23)
unnamed: R25.1, U2.25 (D24)
unnamed: R26.1, U2.24 (D25)
unnamed: R27.1, U2.23 (D26)
unnamed: R28.1, U2.22 (D27)
unnamed: R29.1, U2.21 (D28)
unnamed: R30.1, U2.20 (D29)
unnamed: R31.1, U2.19 (D30)
unnamed: R32.1, U2.17 (D31)
unnamed: R33.1, U3.23 (AD0)
unnamed: R34.1, U3.22 (AD1)
unnamed: R35.1, U3.21 (AD2)
unnamed: R36.1, U3.20 (AD3)
unnamed: R37.1, U3.19 (AD4)
unnamed: R38.1, U3.18 (AD5)
unnamed: R39.1, U3.17 (AD6)
unnamed: R40.1, U3.16 (AD7)
unnamed: R41.1, U3.15 (AD8)
unnamed: R42.1, U3.14 (AD9)
unnamed: R43.1, U3.13 (AD10)
unnamed: R44.1, U3.12 (AD11)
unnamed: R45.1, U3.11 (AD12)
unnamed: R46.1, U3.10 (AD13)
unnamed: R47.1, U3.9 (AD14)
unnamed: R48.1, U3.8 (AD15)
unnamed: R49.1, U3.7 (A16)
unnamed: R50.1, U3.6 (A17)
unnamed: R51.1, U3.5 (A18)
unnamed: R52.1, U3.4 (A19)
unnamed: R53.1, U3.3 (A20)
unnamed: R54.1, U3.2 (A21)
unnamed: R55.1, U3.1 (A22)
unnamed: R56.1, U3.47 (A23)
unnamed: R57.1, U3.46 (A24/~HBF)
unnamed: R58.1, U4.16 (D15)
unnamed: R59.1, U4.17 (D14)
unnamed: R60.1, U4.18 (D13)
unnamed: R61.1, U4.19 (D12)
unnamed: R62.1, U4.20 (D11)
unnamed: R63.1, U4.1 (D10)
unnamed: R64.1, U4.2 (D9)
unnamed: R65.1, U4.3 (D8)
unnamed: R66.1, U4.4 (D7)
unnamed: R67.1, U4.5 (D6)
unnamed: R68.1, U4.6 (D5)
unnamed: R69.1, U4.7 (D4)
unnamed: R70.1, U4.8 (D3)
unnamed: R71.1, U4.9 (D2)
unnamed: R72.1, U4.10 (D1)
unnamed: R73.1, U4.11 (D0)
unnamed: R82.2, U2.61 (RSV1)
unnamed: R83.1, U1.11 (PHI1)
unnamed: R84.1, U1.10 (PHI2)
unnamed: R85.1, U1.9 (RDY)
unnamed: R86.1, U1.5 (~DDIN)
unnamed: R87.1, U1.8 (~RSTO)
unnamed: R88.1, U1.6 (~ADS)
unnamed: R89.1, U1.1 (~DBE)
unnamed: R90.1, U1.4 (~WR)
unnamed: R91.1, U1.3 (~RD)
unnamed: R92.1, U1.23 (~PER)
unnamed: R93.1, U1.15 (FCLK)
unnamed: R94.1, U1.16 (CTTL)
unnamed: R95.1, U1.17 (~TSO)
unnamed: R96.2, U3.26 (PHI1)
unnamed: R97.2, U3.27 (PHI2)
unnamed: R98.2, U3.28 (RDY)
unnamed: R99.2, U3.38 (~DDIN)
unnamed: R100.2, U3.29 (~RSTI)
unnamed: R101.2, U3.44 (~PAV)
unnamed: R102.2, U3.37 (~ADS)
unnamed: R103.2, U3.45 (~INT)
unnamed: R104.2, U3.30 (~HOLD)
unnamed: R105.2, U3.31 (~HLDAI)
unnamed: R106.2, U3.32 (~HLDAO)
unnamed: R107.2, U3.33 (~FLT)
unnamed: R108.2, U3.34 (~RST/~ABT)
unnamed: R109.2, U3.35 (~AT/~SPC)
unnamed: R110.2, U3.36 (U/~S)
unnamed: R111.2, U3.39 (~PFS)
unnamed: R112.2, U3.40 (ST3)
unnamed: R113.2, U3.41 (ST2)
unnamed: R114.2, U3.42 (ST1)
unnamed: R115.2, U3.43 (ST0)
unnamed: R116.2, U2.3 (PHI1)
unnamed: R117.2, U2.2 (PHI2)
unnamed: R118.2, U2.68 (U/~S)
unnamed: R119.2, U2.65 (~AT/~SPC)
unnamed: R120.2, U2.64 (~DS/~FLT)
unnamed: R121.2, U2.63 (~RST/~ABT)
unnamed: R122.2, U2.59 (~BE0)
unnamed: R123.2, U2.58 (~BE1)
unnamed: R124.2, U2.57 (~BE2)
unnamed: R125.2, U2.56 (~BE3)
unnamed: R126.2, U2.55 (~HLDA)
unnamed: R127.2, U2.54 (~HOLD)
unnamed: R128.2, U2.53 (RDY)
unnamed: R129.2, U2.1 (~ADS)
unnamed: R130.2, U2.15 (~INT)
unnamed: R131.2, U2.14 (~NMI)
unnamed: R132.2, U2.13 (~ILO)
unnamed: R133.2, U2.12 (ST0)
unnamed: R134.2, U2.11 (ST1)
unnamed: R135.2, U2.10 (ST2)
unnamed: R136.2, U2.8 (ST3)
unnamed: R137.2, U2.7 (~PFS)
unnamed: R138.2, U2.6 (~DDIN)
unnamed: R139.2, U2.67 (RSV4)
unnamed: R140.2, U2.66 (RSV3)
unnamed: R141.2, U2.62 (RSV2)
unnamed: R142.2, U4.15 (~RST)
unnamed: R143.2, U4.14 (CLK)
unnamed: R144.2, U4.22 (ST1)
unnamed: R145.2, U4.23 (ST0)
unnamed: R146.2, U4.21 (~SPC)
unnamed: R172.2, U1.2 (~RWEN/SYNC)
unnamed: R173.2, TP5.1, U1.18 (~WAIT8)
unnamed: R174.2, TP4.1, U1.19 (~WAIT4)
unnamed: R175.2, TP3.1, U1.20 (~WAIT2)
unnamed: R176.2, TP2.1, U1.21 (~WAIT1)
unnamed: R177.2, TP1.1, U1.22 (~CWAIT)
unnamed: R188.2, U17.9
unnamed: R189.1, U17.8
unnamed: R237.2, U1.14 (XOUT)
unnamed: R306.2, U17.5
unnamed: R307.1, U17.6
unnamed: R324.2, U2.9 (RSV5)
unnamed: U1.13 (XIN), Y1.2
PAV: R189.2, U14.11 (Load), U15.11 (Load), U16.11 (Load)
PHI1: R83.2, R96.1, R116.1
PHI2: R84.2, R97.1, R117.1
RDY: R85.2, R98.1, R128.1
RST: R307.2
RSV2: R141.1
RSV3: R140.1
RSV4: R139.1
ST0: R115.1, R133.1, R145.1
ST1: R114.1, R134.1, R144.1
ST2: R113.1, R135.1
ST3: R112.1, R136.1
U/~S: R110.1, R118.1, TP10.1
~ABT: R108.1, R121.1, R178.1, R181.1
~ADS: R102.1, R129.1, R179.2, R182.1
~AEN: R190.2, U14.1 (OE), U15.1 (OE), U16.1 (OE)
~BE0: R122.1
~BE1: R123.1
~BE2: R124.1
~BE3: R125.1
~DBE: R89.2, U10.19 (CE), U11.19 (CE), U12.19 (CE), U13.19 (CE)
~DDIN: R86.2, R99.1, R138.1, R185.1, U10.1 (A->B), U11.1 (A->B), U12.1 (A->B), U13.1 (A->B)
~FLT: R107.1, R120.1, R184.1
~HLDAO: R106.1, R323.1, TP11.1
~HLDA: R105.1, R126.1, R323.2
~HOLD: R104.1, R127.1, R239.1
~ILO: R132.1, R186.1
~INT: R130.1, R326.1
~NMI: R103.1, R131.1, R183.1
~PAV: R88.2, R101.1, R179.1, R188.1
~PER: R92.2, R191.1
~PFS: R111.1, R137.1
~RD: R91.2
~RSTI: C30.2, D1.1 (A), R238.1, SW2.2 (B), TP6.1, U1.7 (~RSTI)
~RST: R87.2, R100.1, R142.1, R178.2, R306.1, TP9.1
~SPC: R109.1, R119.1, R146.1, R180.1
~TSO: R95.2, TP7.1
~WR: R90.2

Notes on the sheet:
Fit if MMU not fitted
MMU
FPU
Fit R324 and R325 for NS32C023 DNF for NS32032
CPU
TCU
